PavLados/dvig_ros_solution/scheme.jpg

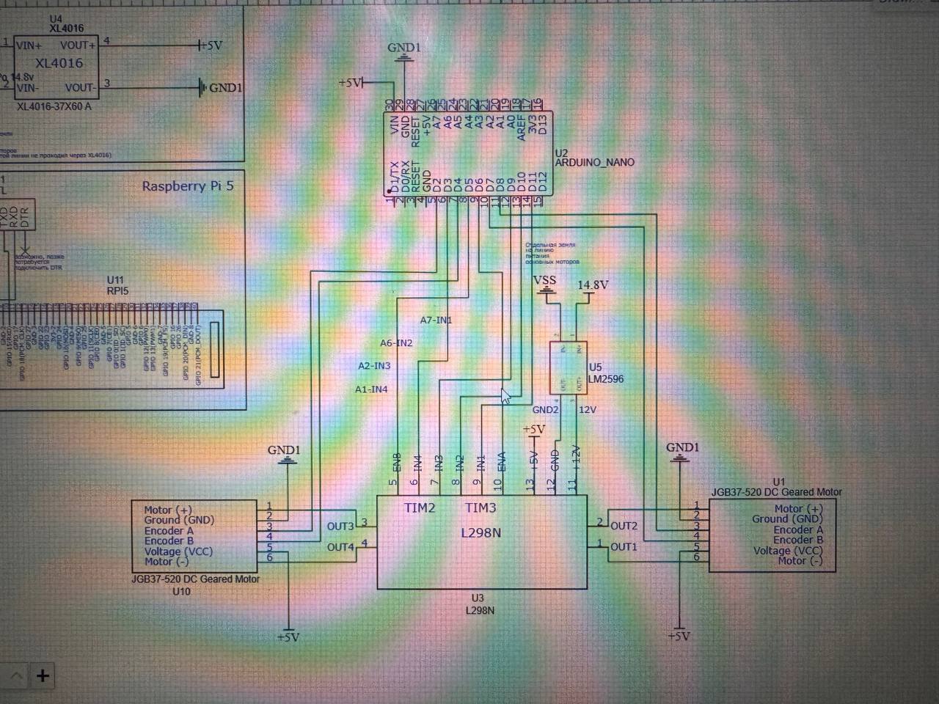
scheme.jpg
