PavLados/dvig_ros_solution/README.md

# dvig_ros_solution

Ссылка на диск с 3д моделями: https://drive.google.com/drive/folders/1PYUKaMeUFjQy0ujeJ0u9oXuvR4lp3E8L?usp=drive_link
