PavLados/dvig_ros_solution/файлы для печати и резки/печать/пояснения к печати.docx

Для печати использовался принтер Bambu Lab X1E с комплектной пластиной, создание gcod производилось в BambuStudio

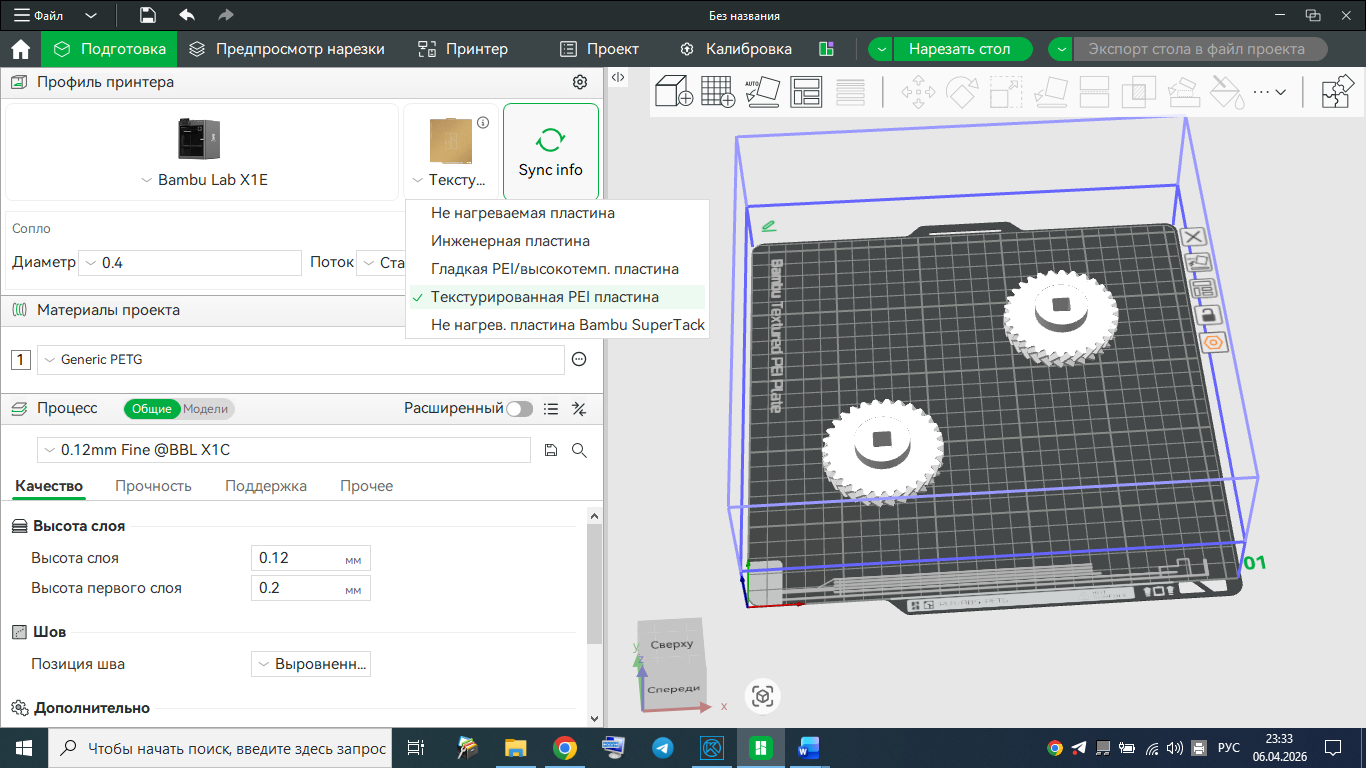
[picture p15: figure]

Для печати модели из компас 3д экспортировались в формат step, затем step файлы экспортировались в среду BambuStudio с предложенными программой параметрами

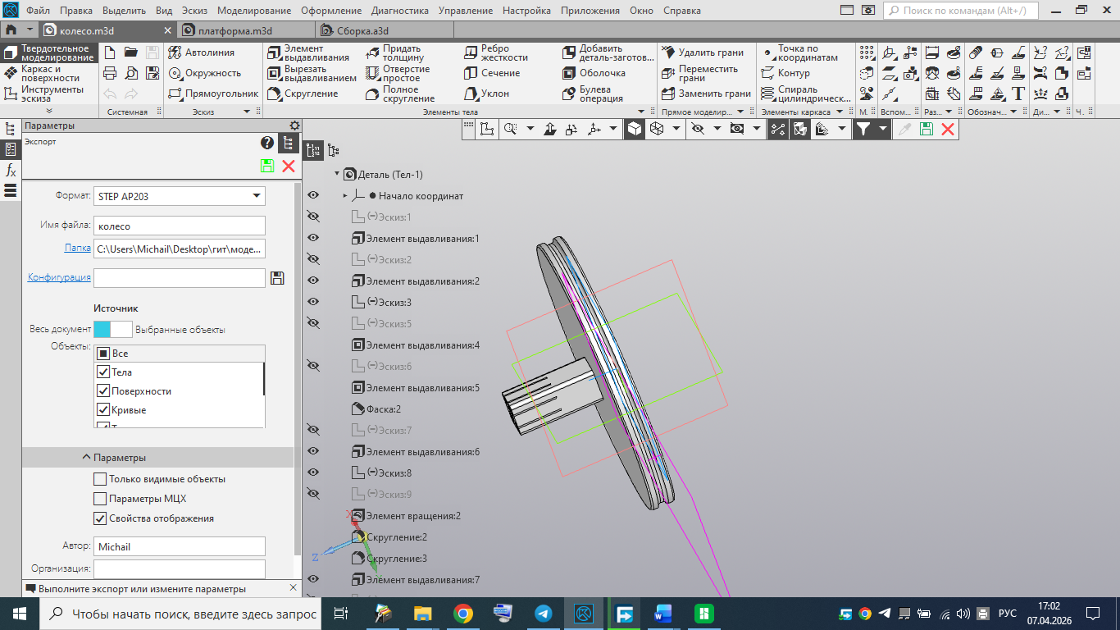
[picture p16: figure]
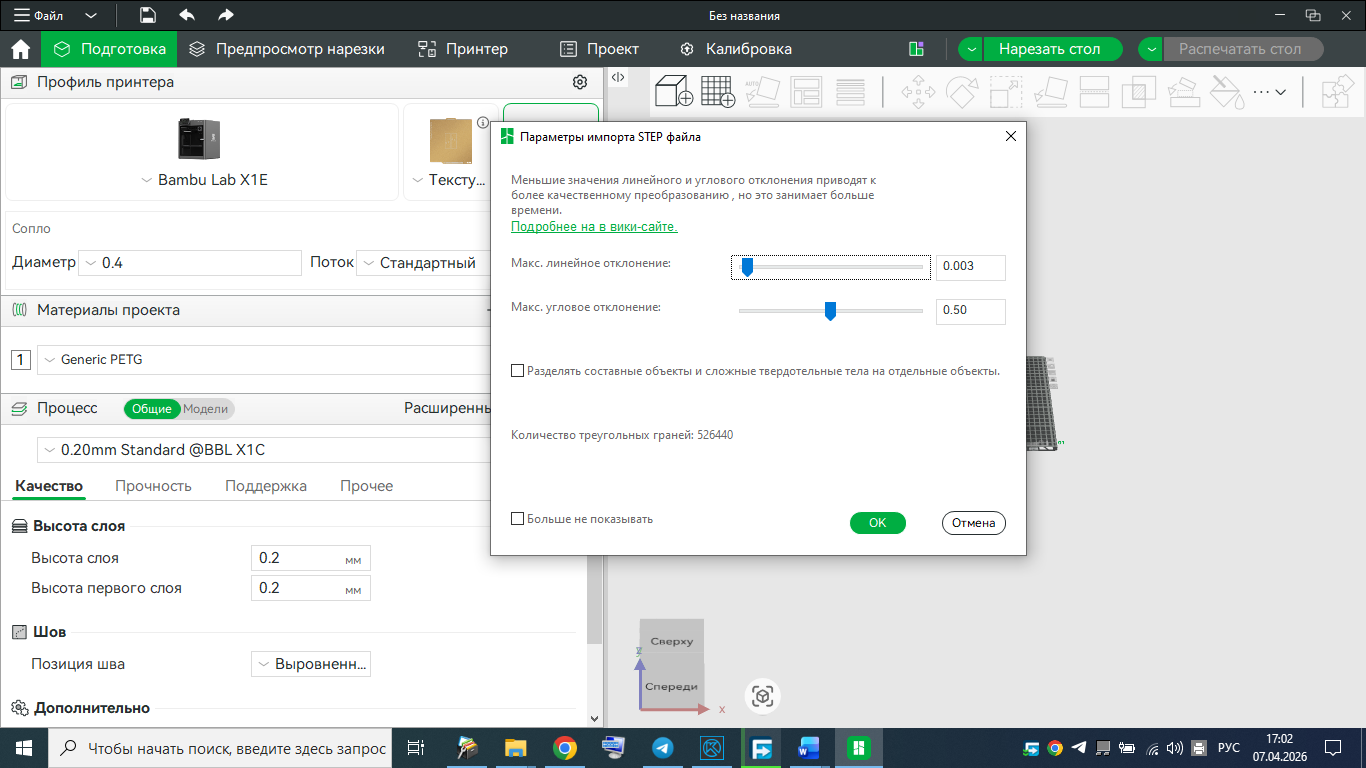
[picture p17: figure]

Выбранный пластик – petg, предворительно просушен https://bambulab.3d-outlet.ru/shop/tproduct/625814560142-sushilka-filamenta-bambu-lab-ams-ht

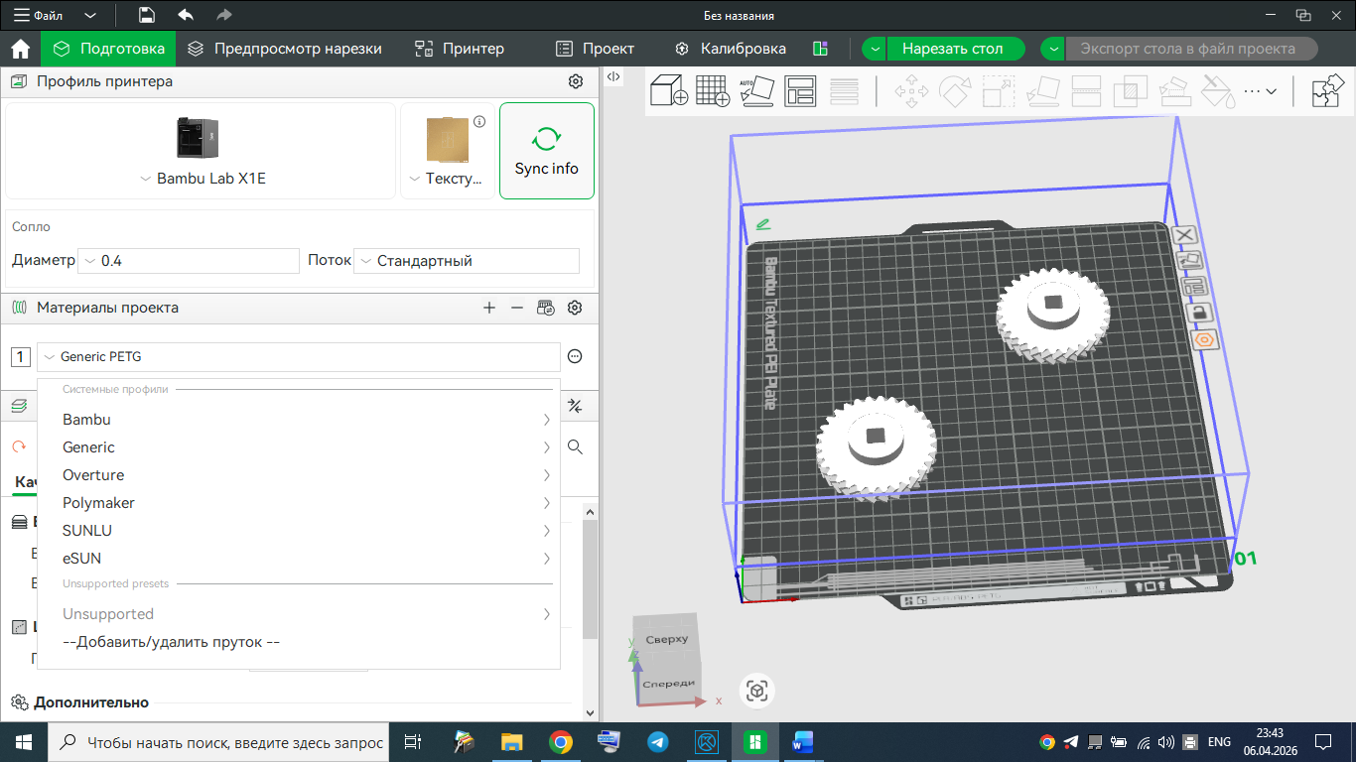
[picture p18: figure]

Настройка стола – печать моделей по очереди

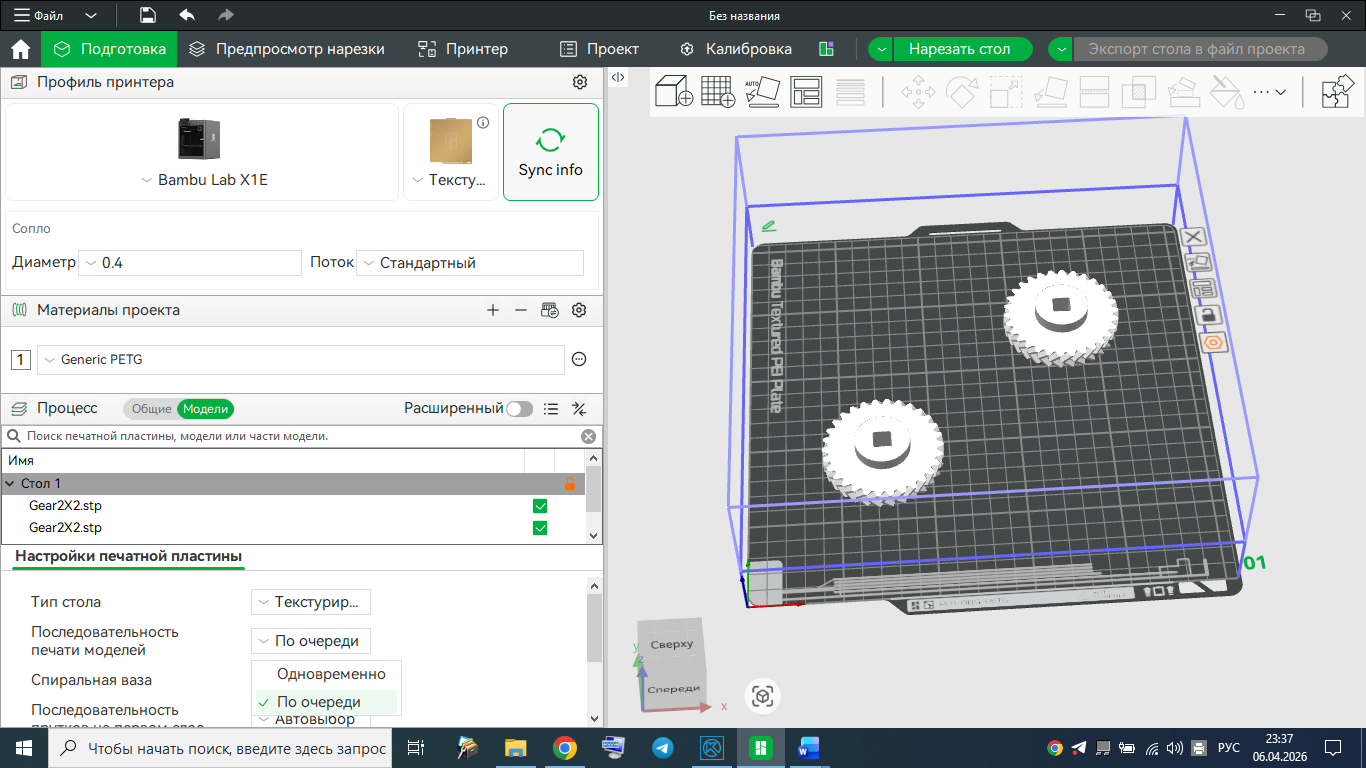
[picture p19: figure]

Высота слоя для всех моделей кроме шестерен

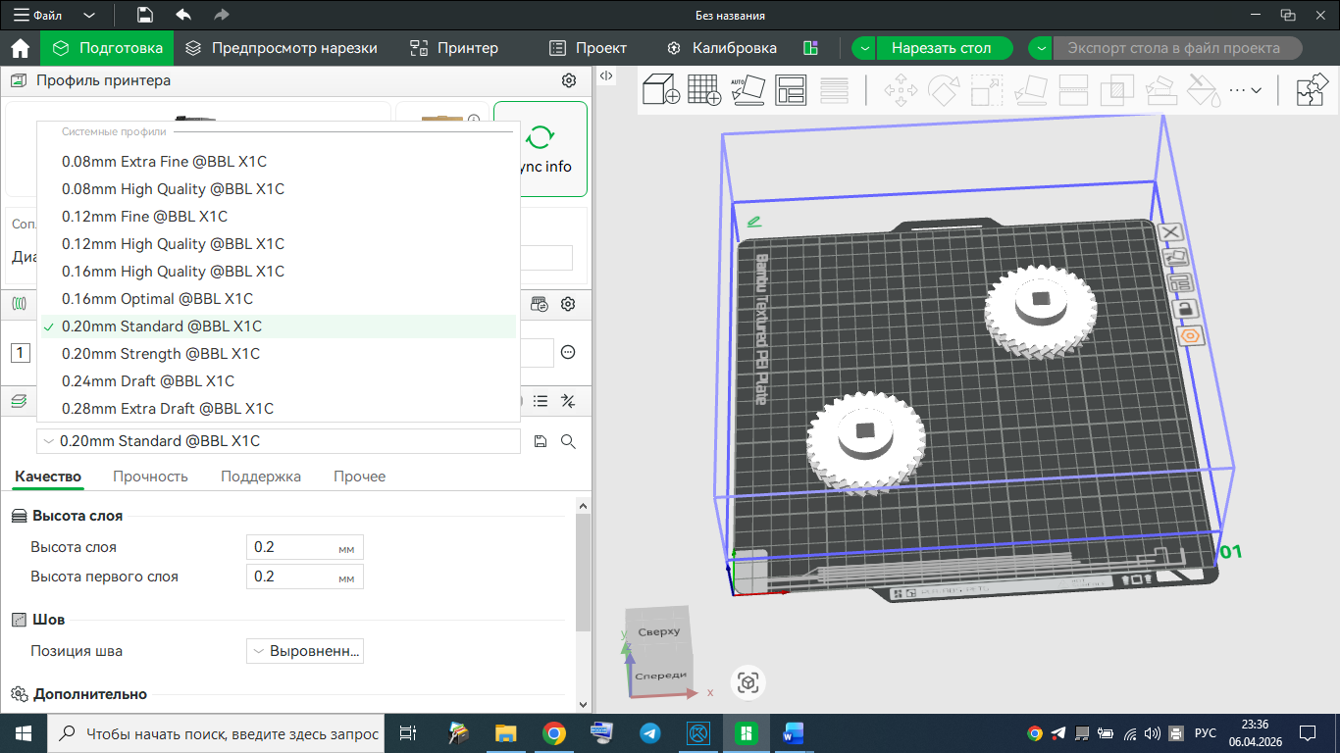
[picture p20: figure]

Высота слоя для шестерен

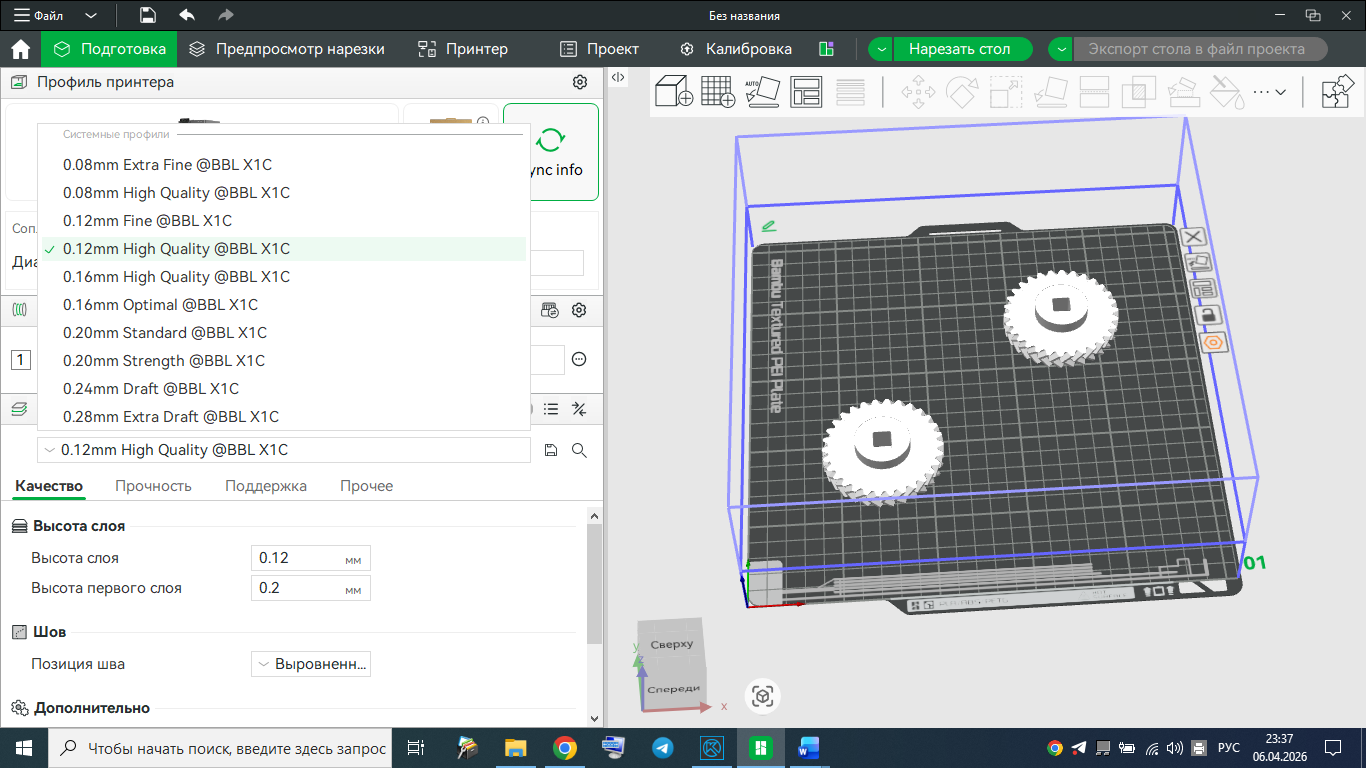
[picture p21: figure]

Количество стенок для шестерен нестандартное – 10 стенок

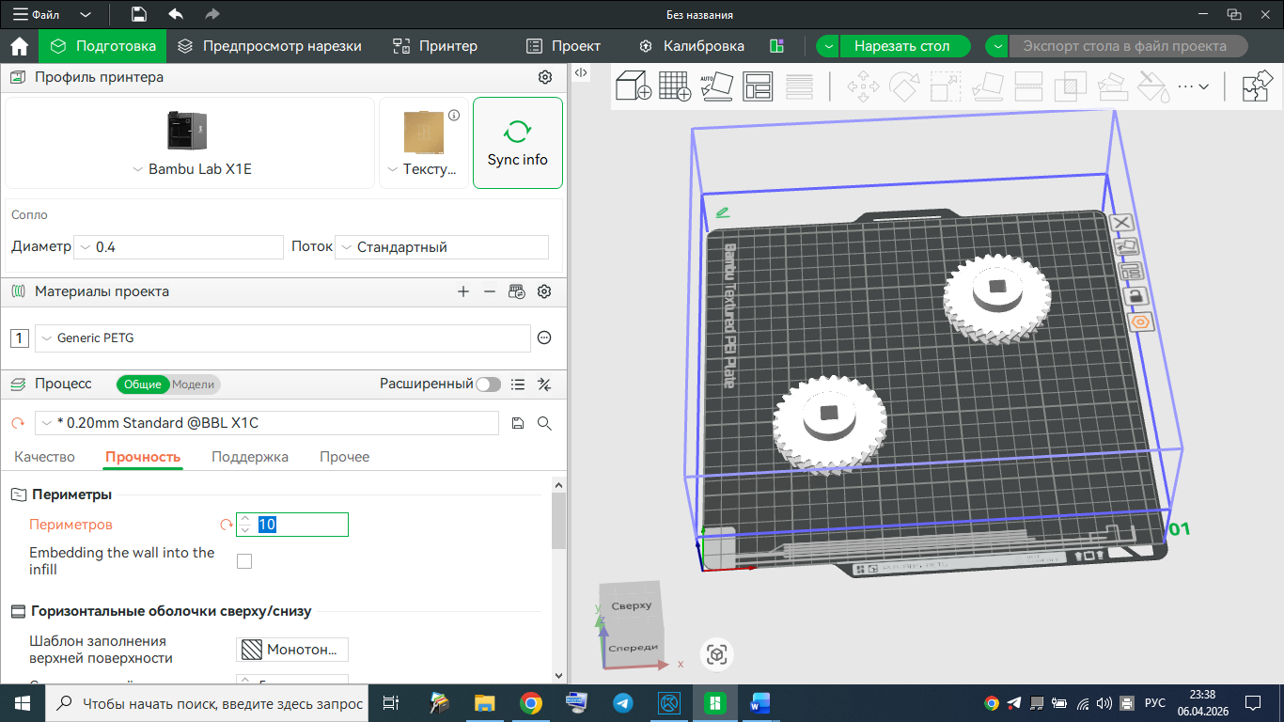
[picture p22: figure]
