PavLados/dvig_ros_solution/файлы для печати и резки/резка/пояснения к лазерной резке.docx

Лазерная резка производилась на станке Wattsan на контроллере RDC6445S с рабочей областью 300мм*500мм с комплектной оснасткой, т.к. работа лазера зависит от времени наработки лазерной трубки, параметры резки – индивидуальны и подбираются согласно рекомендациям производителя или эмпирическим путем.

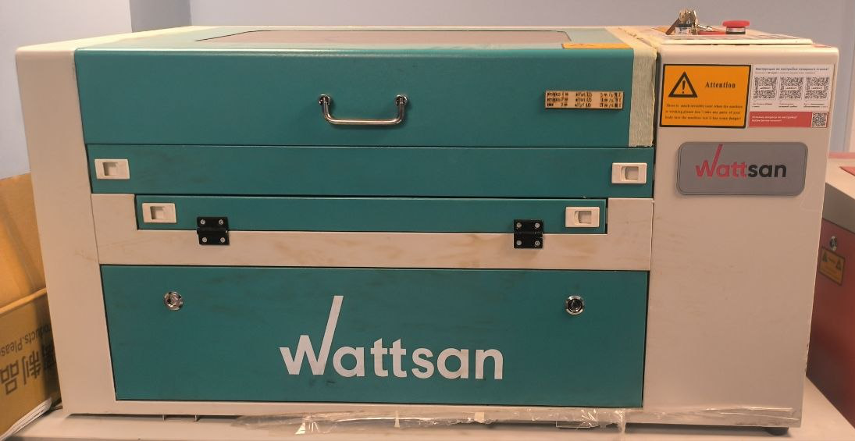
[picture p23: figure]

Для формирования контура резки по готовой 3d модели, проще всего воспользоваться функцией «Спроецировать объект», нажать левую кнопку мыши по поверхности.

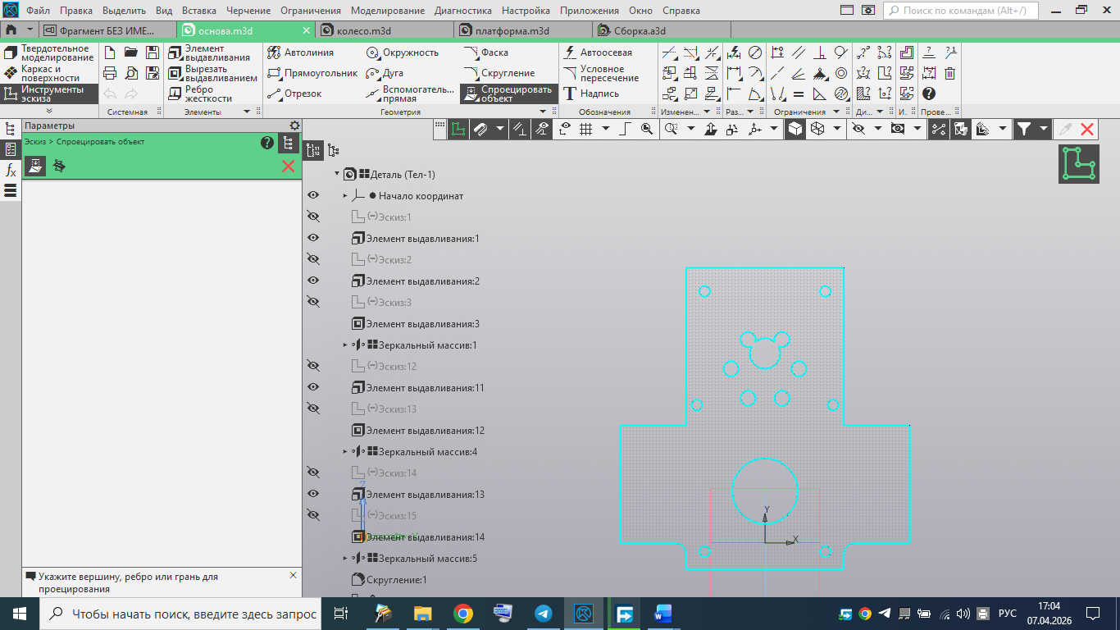
[picture p24: figure]

Скопировать полученный контур.

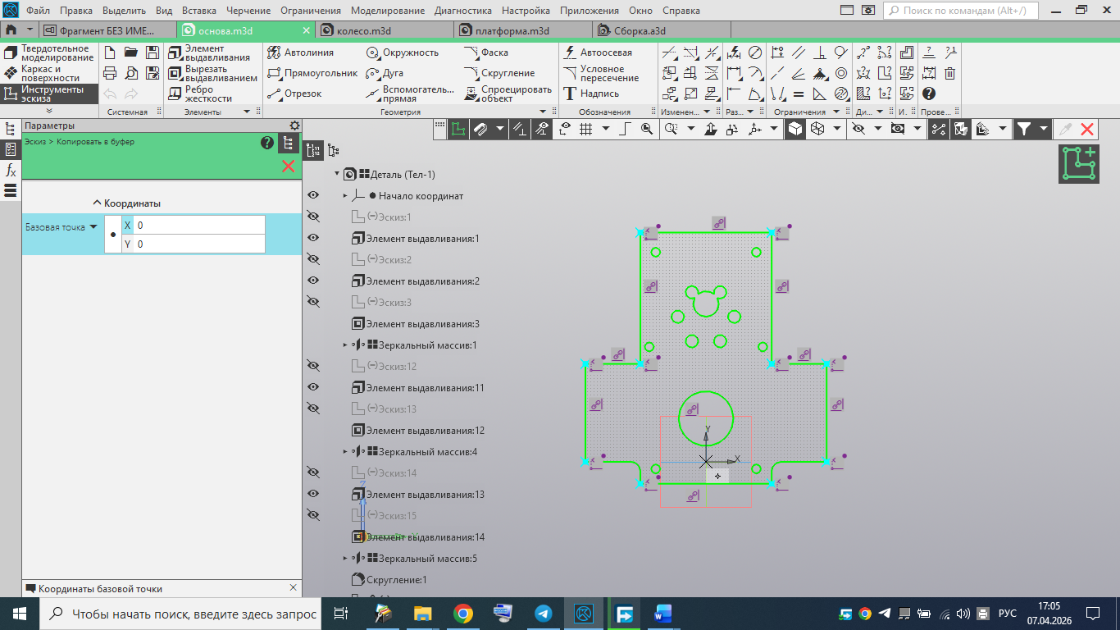
[picture p25: figure]

Создать файл фрагмент.

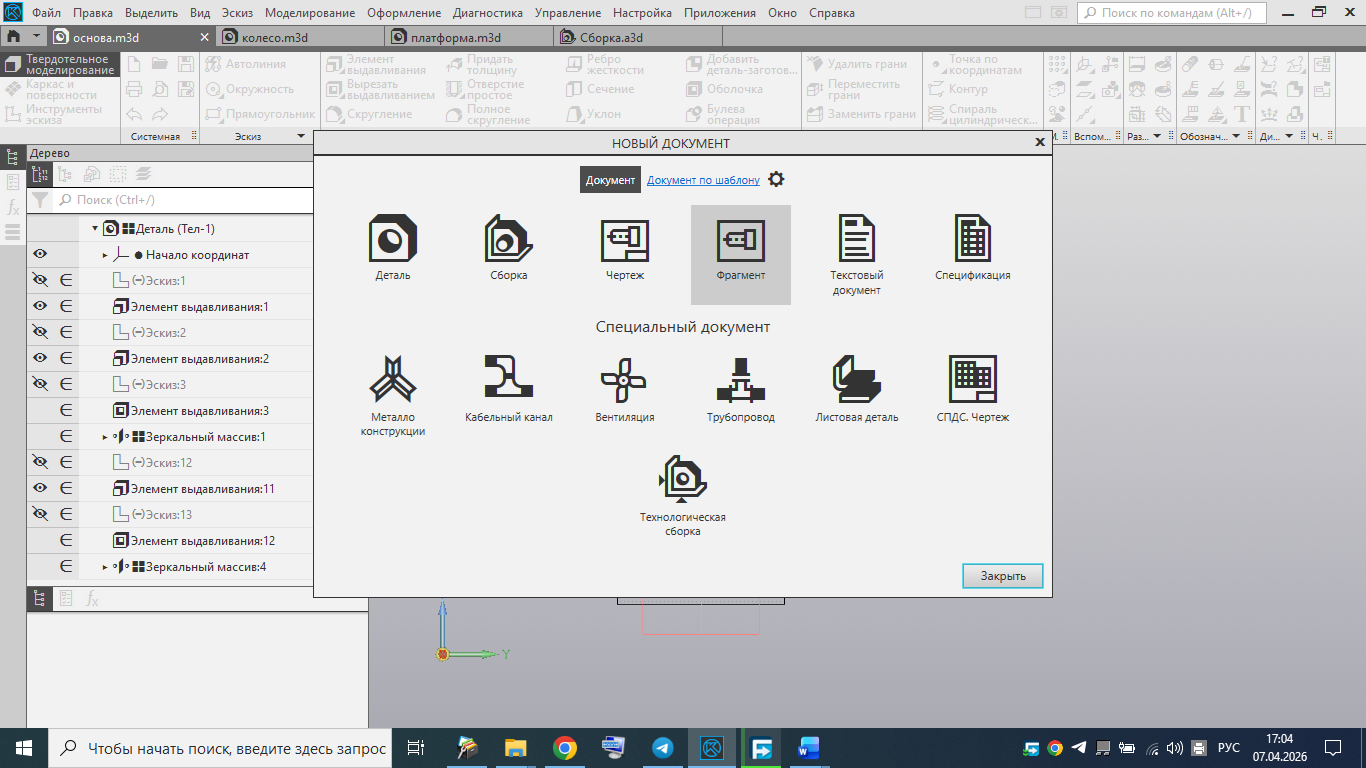
[picture p26: figure]

Вставить в новый файл скопированный контур.

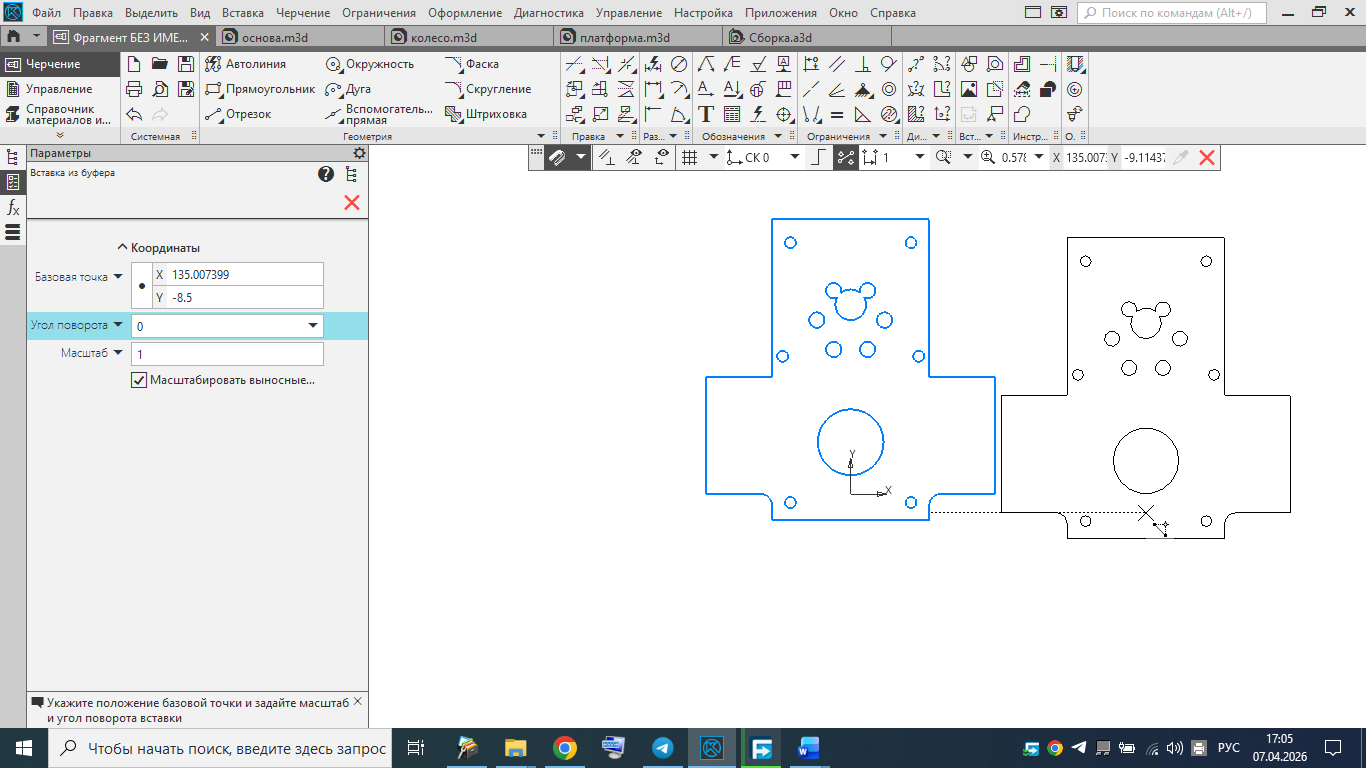
[picture p27: figure]

Сохранить фрагмент в формате DXF с названием из латинских букв.

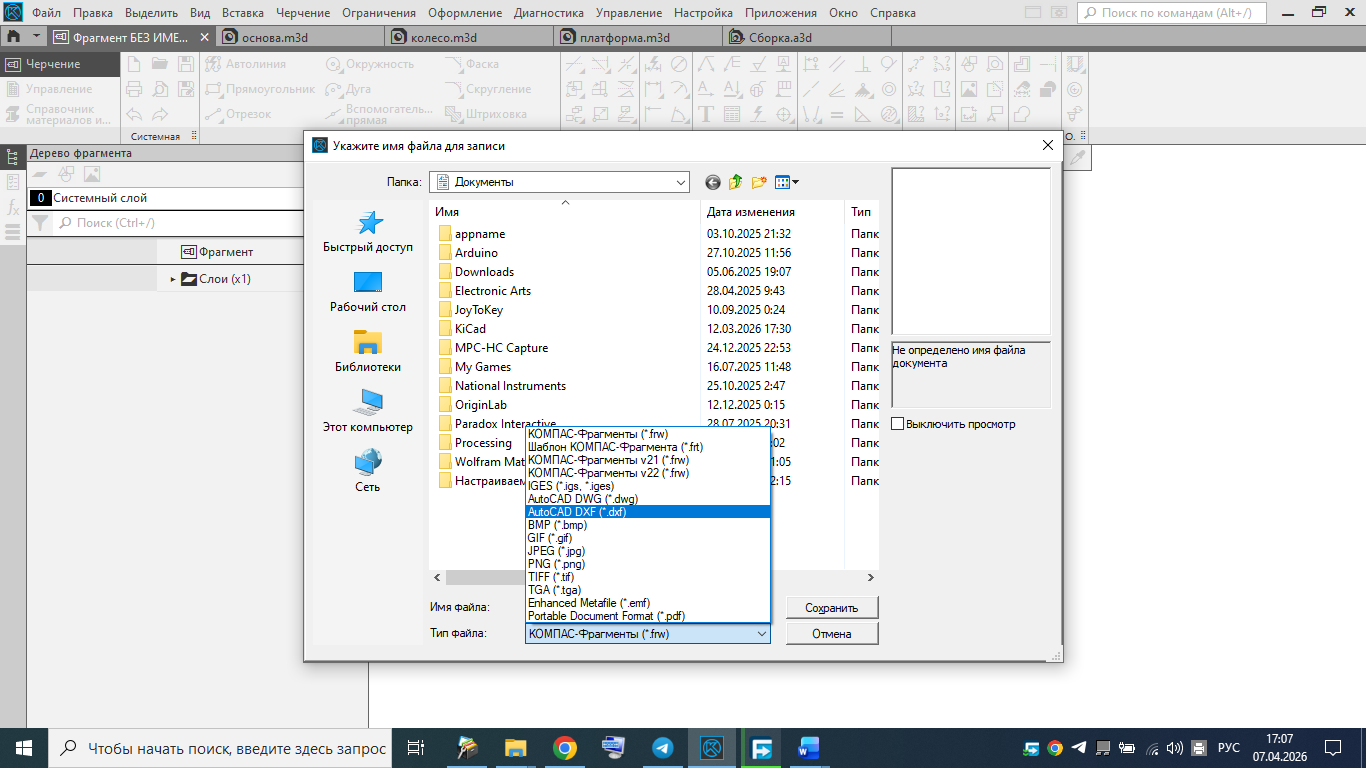
[picture p28: figure]

Импортировать DXF файл в среду RDWorks.

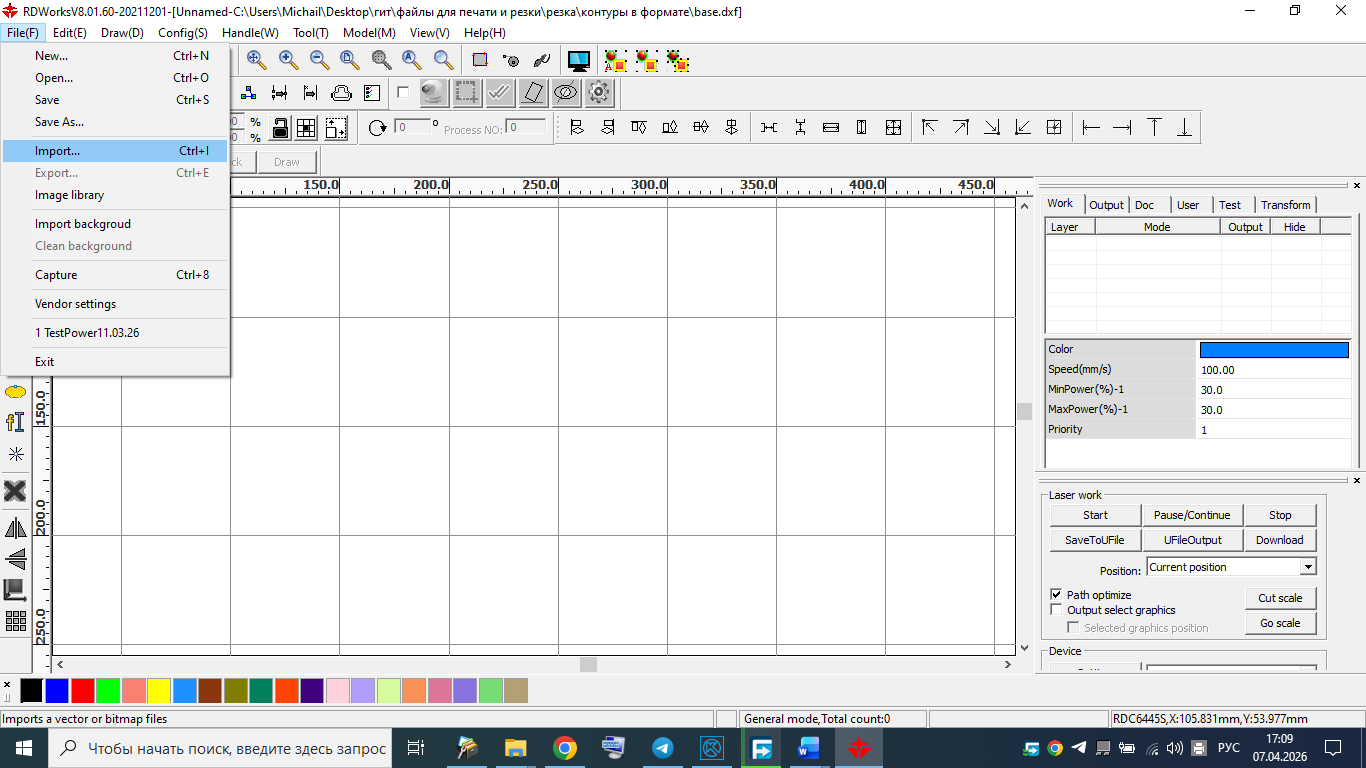
[picture p29: figure]
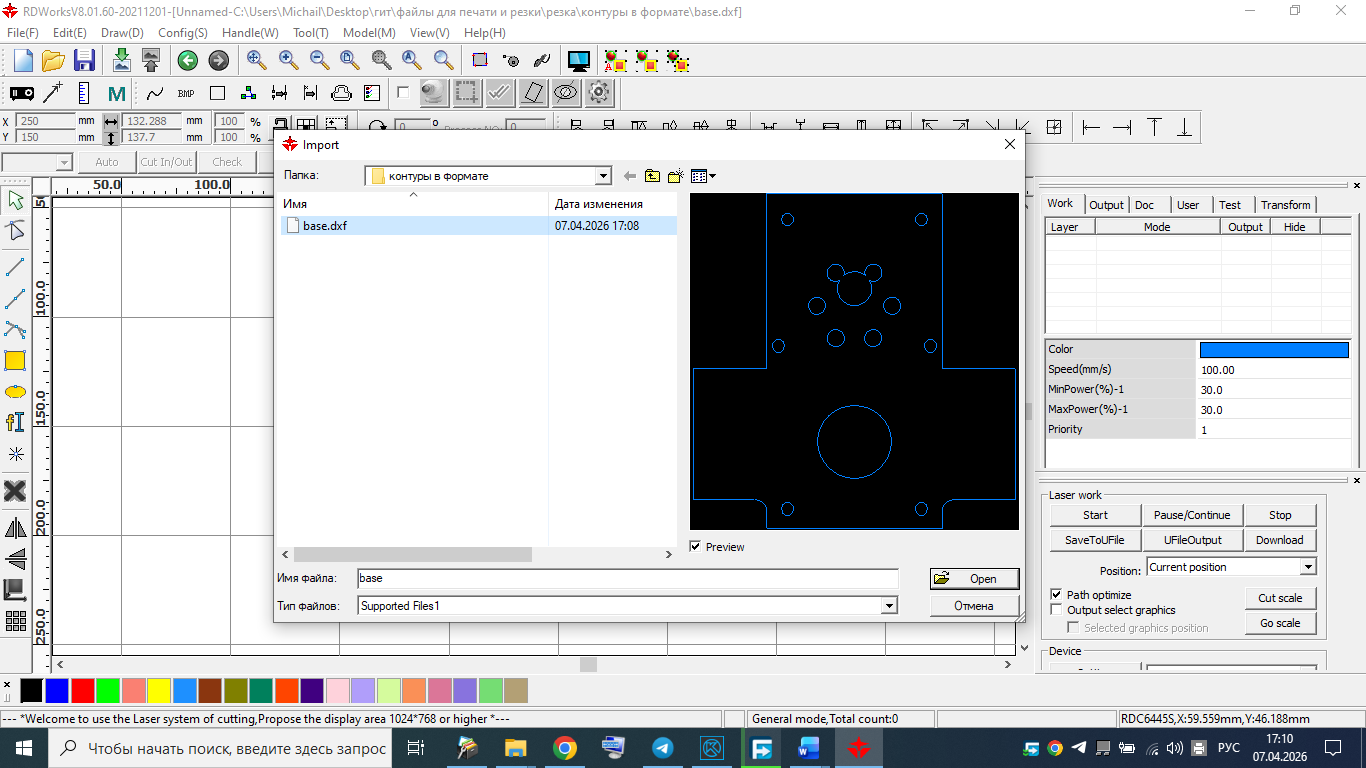
[picture p30: figure]

И расположить контур используя функционал программы. Также на фото показаны параметры резки для лазерной трубки с временем наработки 400 часов, которые подобраны эмпирически.

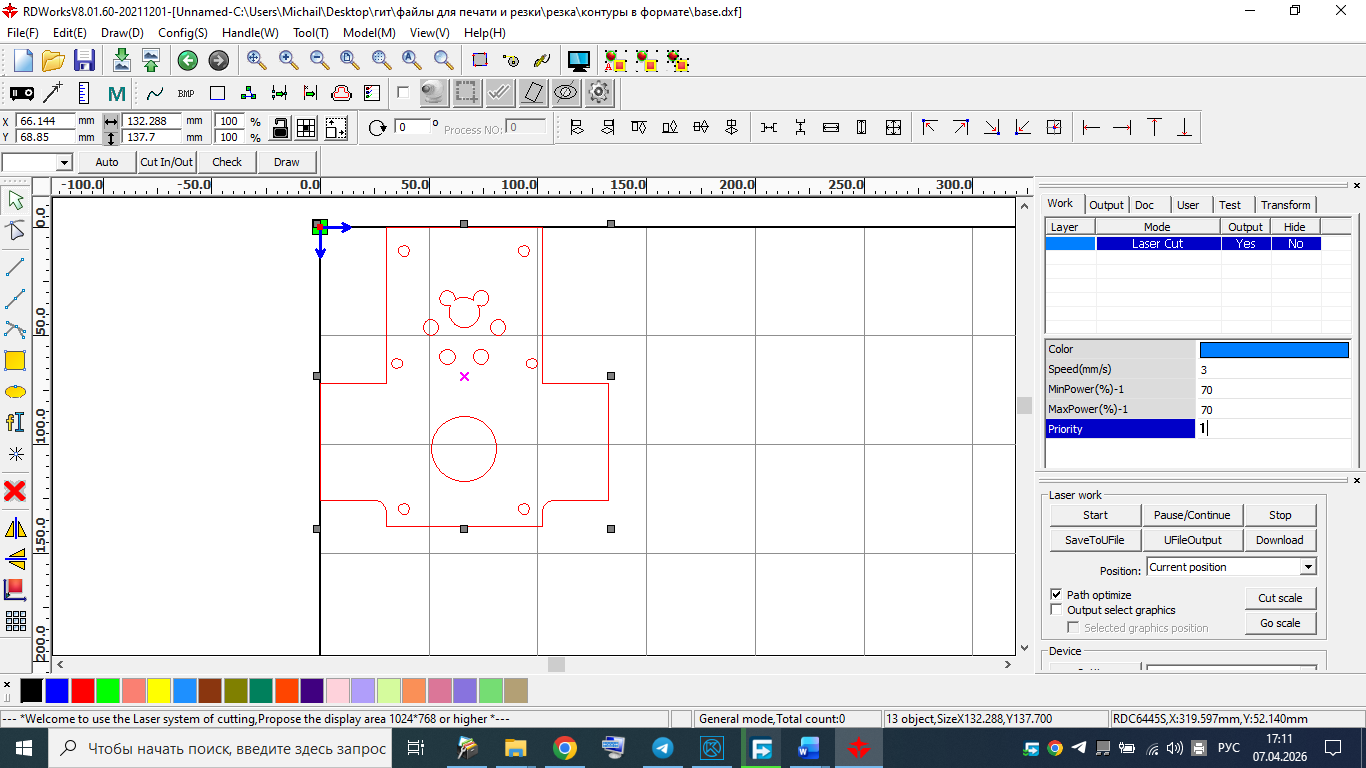
[picture p31: figure]
