PavLados/dvig_ros_solution/Schematic_Competitive_Robot_Scheme_No_Servos_Arduino_2_2026-04-11.png

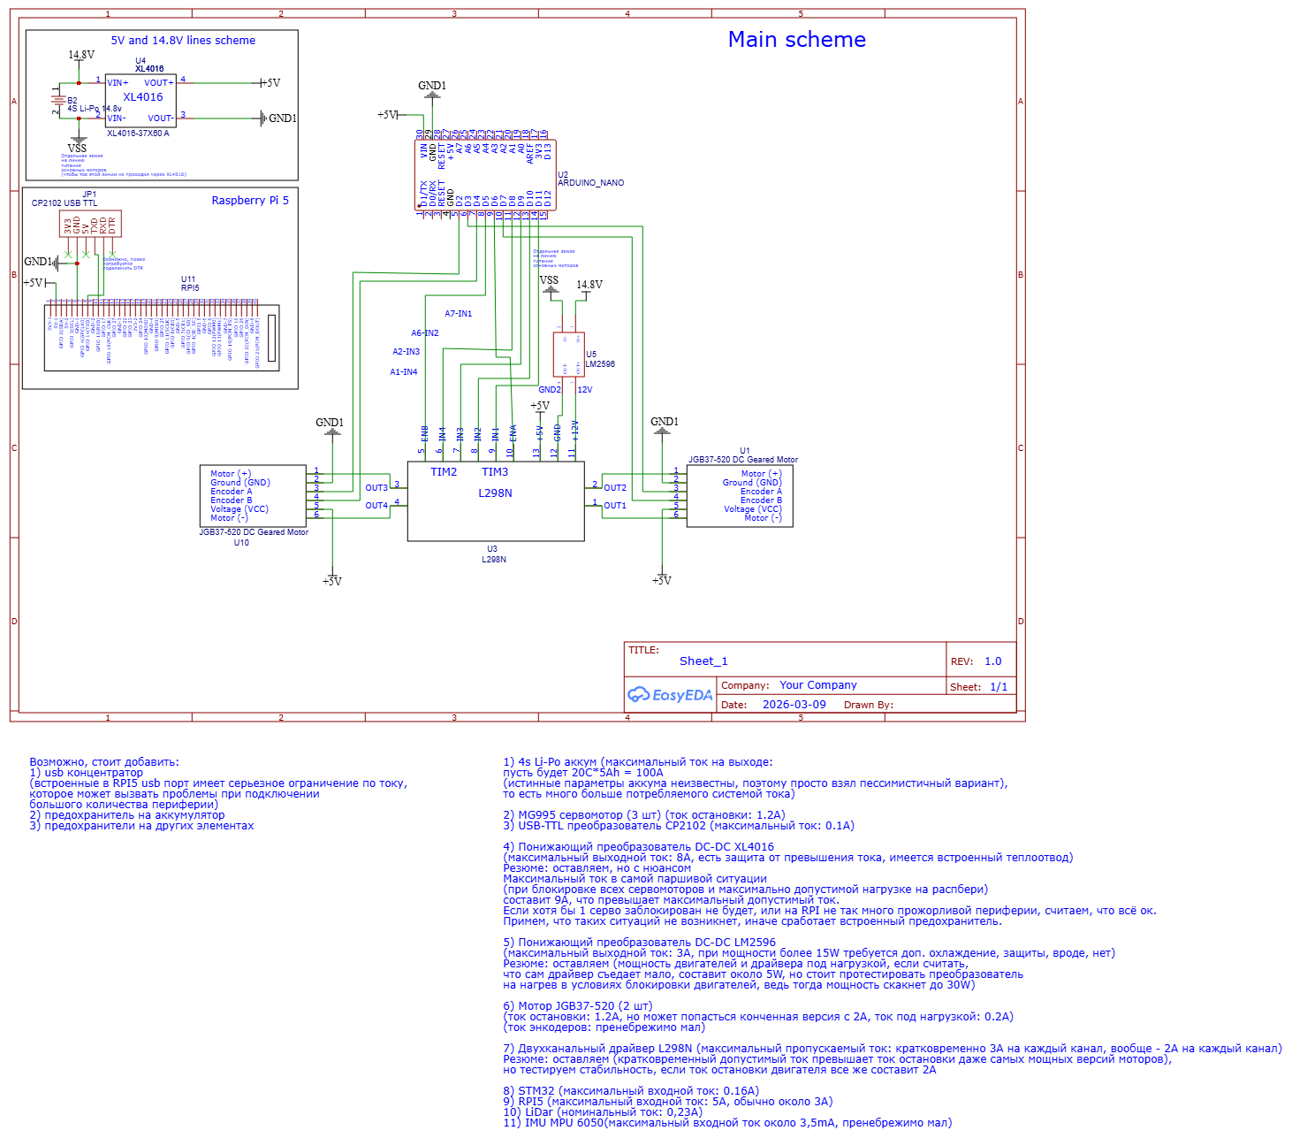
Schematic_Competitive_Robot_Scheme_No_Servos_Arduino_2_2026-04-11.png
