PavLados/dvig_ros_solution/файлы для печати и резки/печать/модели в формате step/wheelX2.stp

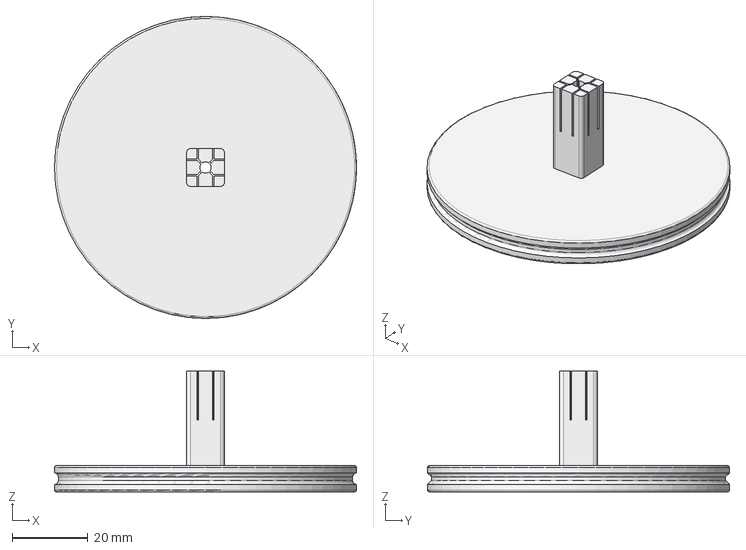
[picture p33: CAD file, 2026-04-07]
файлы для печати и резки/печать/модели в формате step/wheelX2.stp
80.0 x 80.0 x 32.0 mm
