PavLados/dvig_ros_solution/файлы для печати и резки/резка/контуры в формате DXF/base.dxf

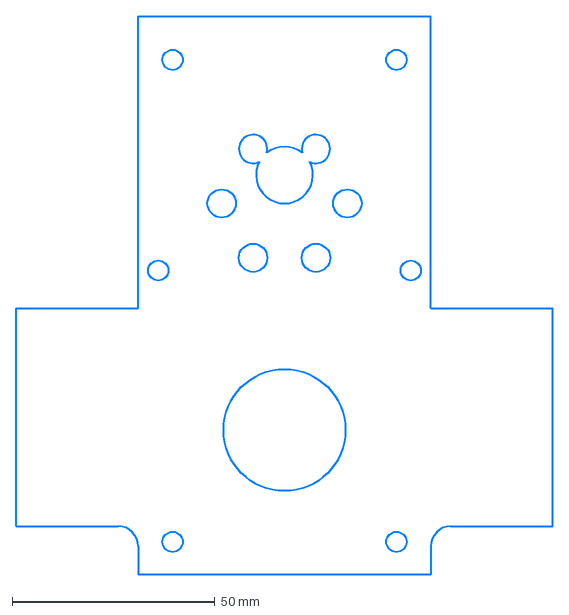
[picture p34: CAD file, 2026-04-07]
файлы для печати и резки/резка/контуры в формате DXF/base.dxf
132.3 x 137.7 mm
