PavLados/dvig_ros_solution/файлы для печати и резки/печать/модели в формате step/sleeve_nutX8.stp

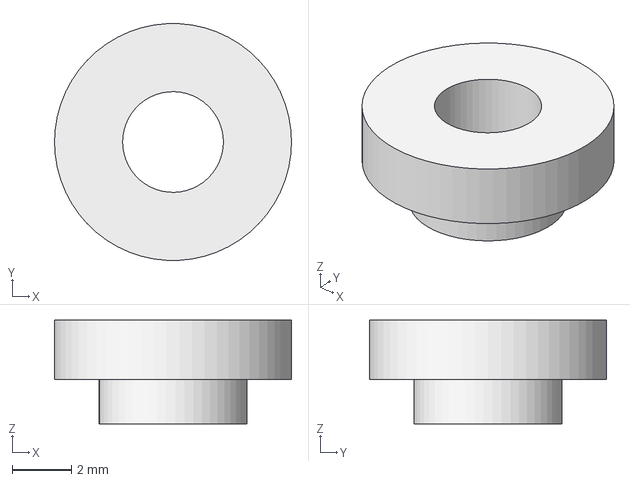
[picture p35: CAD file, 2026-04-07]
файлы для печати и резки/печать/модели в формате step/sleeve_nutX8.stp
8.00 x 7.99 x 3.50 mm
