PavLados/dvig_ros_solution/файлы для печати и резки/печать/модели в формате step/Motor mountX2.stp

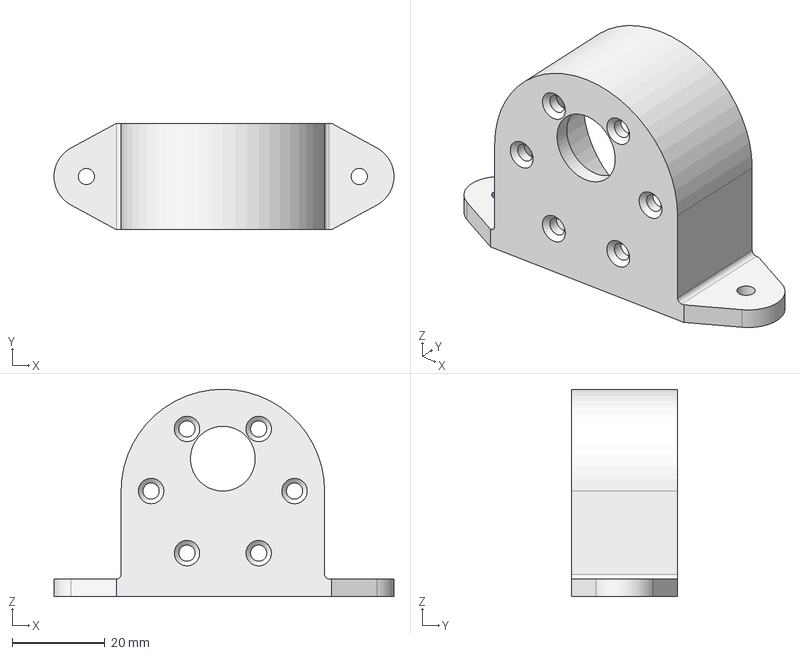
[picture p36: CAD file, 2026-04-07]
файлы для печати и резки/печать/модели в формате step/Motor mountX2.stp
73.5 x 23.0 x 44.8 mm
