PavLados/dvig_ros_solution/файлы для печати и резки/печать/модели в формате step/transmission coverX2.stp

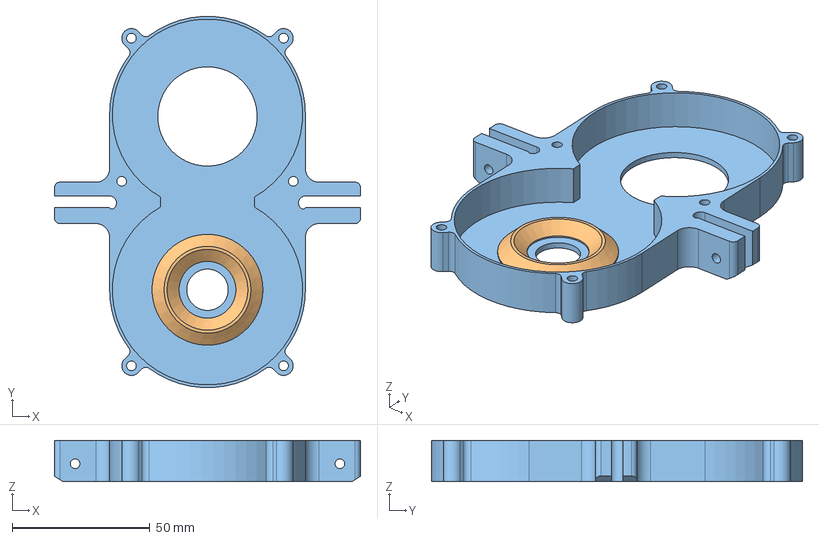
[picture p37: CAD file, 2026-04-07]
файлы для печати и резки/печать/модели в формате step/transmission coverX2.stp
111.0 x 134.5 x 15.0 mm
