PavLados/dvig_ros_solution/файлы для печати и резки/печать/модели в формате step/bushing_supportX4.stp

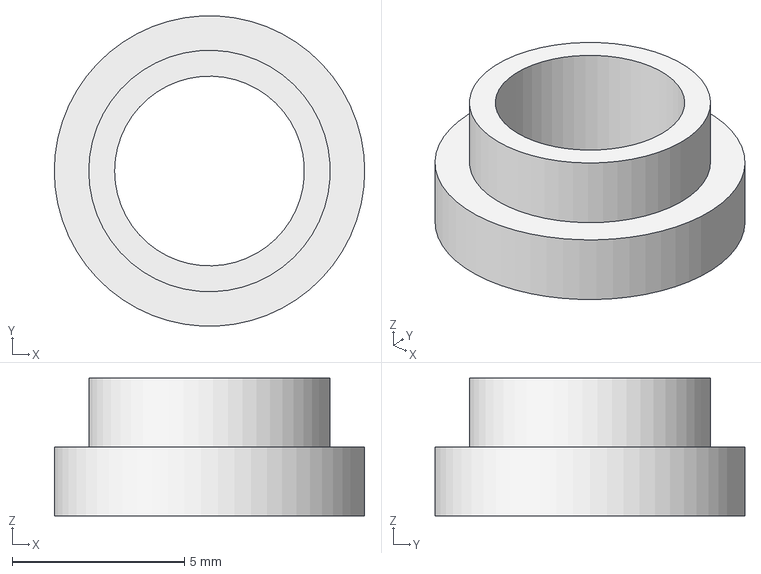
[picture p38: CAD file, 2026-04-07]
файлы для печати и резки/печать/модели в формате step/bushing_supportX4.stp
9.00 x 8.99 x 4.00 mm
