PavLados/dvig_ros_solution/файлы для печати и резки/печать/модели в формате step/washer_gearX2.stp

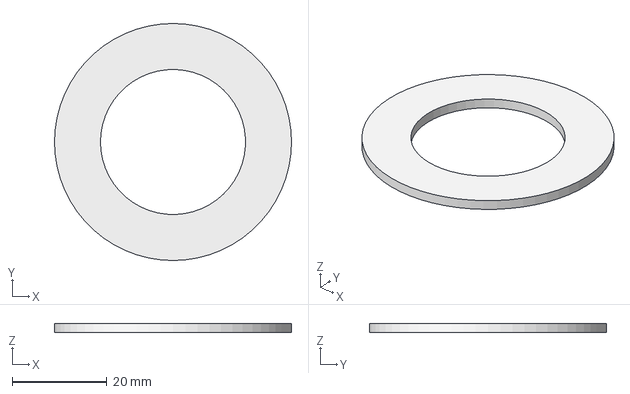
[picture p40: CAD file, 2026-04-07]
файлы для печати и резки/печать/модели в формате step/washer_gearX2.stp
50.0 x 50.0 x 2.00 mm
