PavLados/dvig_ros_solution/(list of files, cad)

Other CAD files:
файлы для печати и резки/печать/gcod файлы для 3d печати/sleeve_nutX8.gcode.3mf
файлы для печати и резки/печать/gcod файлы для 3d печати/bushing_supportX4.gcode.3mf
файлы для печати и резки/печать/gcod файлы для 3d печати/Motor mountX2.gcode.3mf
файлы для печати и резки/печать/gcod файлы для 3d печати/wheelX2.gcode.3mf
файлы для печати и резки/печать/gcod файлы для 3d печати/transmission coverX2.gcode.3mf
файлы для печати и резки/печать/gcod файлы для 3d печати/sleeve_screwX8.gcode.3mf
файлы для печати и резки/печать/gcod файлы для 3d печати/washer_gearX2.gcode.3mf
